domgarr/ScoreboardManager/(threads)

Thread 1 (2018-05-18):

At possible point, after "Spin to Win" is rendered, the losing team side does not update.

domgarr, 2018-05-18:
As of now, when pressing plus/minus button only one side of the scoreboard is updated. This leaves the score at "24 : Win" . Since the right side, which is losing, does not update because we gave the left side a point thus only rendering the left side.

domgarr, 2018-05-21:
Fixed by changing renderScore method to always render, before for rendering to occur the prev/curr state of the scores had to be different.

Closed 2018-05-21.

Thread 3 (2018-05-18):

Correct input values of NO switch such that plus/minus are adjacent.

domgarr, 2018-05-18:
This is pertaining to input values the NO switch are connected to on the board.
While testing the board, I tested out different input values on the board. IE, I switch the red plus NO switch to 3 and red minus NO switch to 11. This seems random, but it did so because the switches weren't activating prior to switching. What i think the problem is , is that since i haven't soldered the connection yet, it is very weak.
This should be done for readability and plainly due to the fact that it makes sense.

domgarr, 2018-05-21:
Fixed blue pin references are now adjacent (3,5) and red pins are (12,13). The gap between the numbers allowed for less congestion between the wires.

Closed 2018-05-21.

Thread 4 (2018-05-21):

Buttons pressed and rendering

domgarr, 2018-05-21:
I recently changed the buttons to render conditionally, but that isn't needed for the buttons, because we aren't checking another source - the watch - to see if there was a change. We know if the buttons are pressed, the states are not the same, render!

domgarr, 2018-05-22:
Fixed. I was correct in the button presses not needing conditional rendering.

Closed 2018-05-22.
