domgarr/ScoreboardManager/(commit log)

2018-01-29 Fixed a bug where 'Spin to Win would flash after the game was won
    [scoreboard_manager.ino]
2018-05-16 feat: Added flag for button mode and added controllers for blue side plus/minus refactor: Extracted rendering to methods
2018-05-18 feat: added red buttons for plus/minus, added reset button refactor: deleted unused code
2018-05-21 refactor: Changed button pins references so same colored buttons are adjacent
2018-05-21 Commited to wrong branch This reverts commit 514929eb7f4bf1a00c985ba7b6079fa3b70bb484.
    [scoreboard_manager.ino]
2018-05-21 refactor: Change button pins references, such that same colored buttons are adjacent
2018-05-21 bug: Readd deleted mappings for displaying "Spin to Win"
    [scoreboard_manager.ino]
2018-05-21 bugfix: Opposing team score now updates after "Spin to Win" is flashed. refactor: renderScore refactored to allow for rendering score even if prev/curr scores are the same and extracted rendering con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
    [scoreboard_manager.ino]
2018-05-22 refactor: remove conditional rendering on button presses
2018-06-18 feat: decrease brightness of LEDs refactor: remove unecessary check in watch mode
2019-09-16 Move scoreboard_manager.ino into a folder, as required by Arduino ide
2019-09-16 Move BluefruitConfig to correct folder
    [scoreboard_manager.ino]
