domgarr/ScoreboardManager/images/backside.jpg

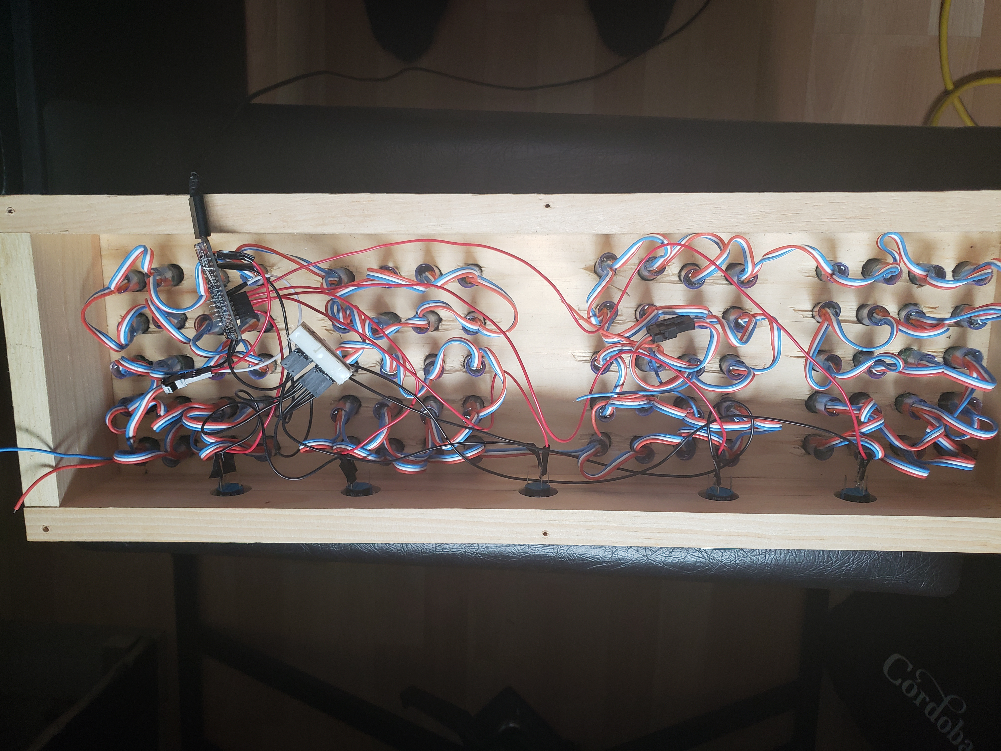
[picture p5: images/backside.jpg]
images/backside.jpg
