domgarr/ScoreboardManager/images/micro_back.jpg

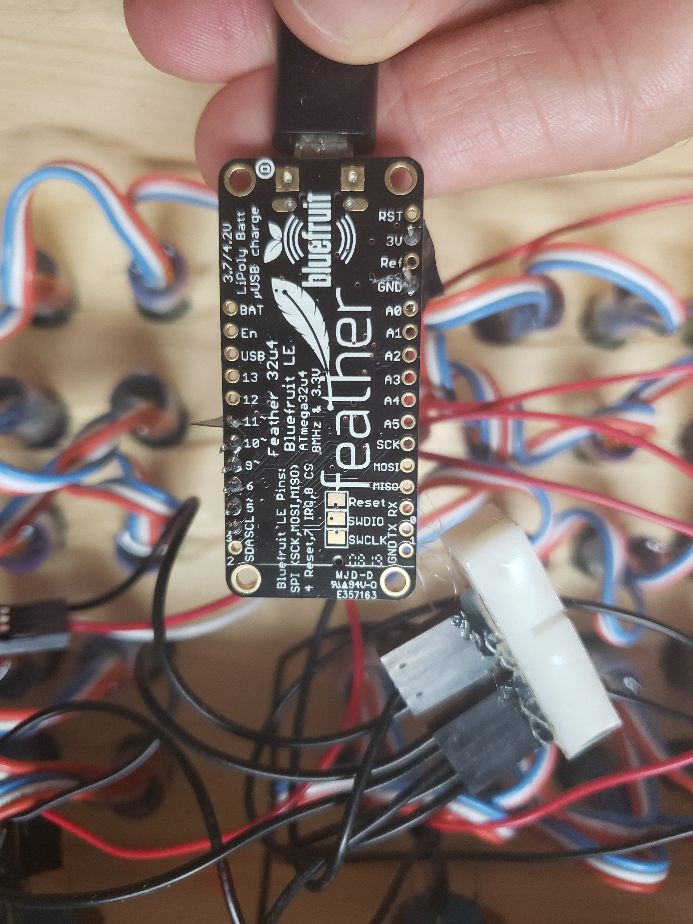
[picture p9: images/micro_back.jpg]
images/micro_back.jpg
