domgarr/ScoreboardManager/images/breadboard.jpg

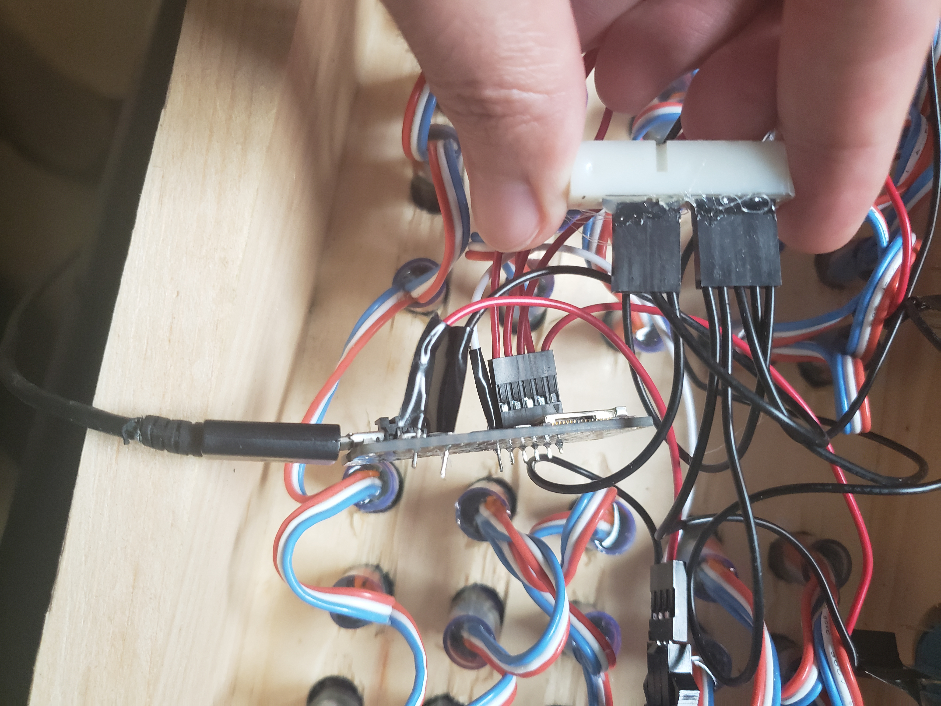
[picture p10: images/breadboard.jpg]
images/breadboard.jpg
