domgarr/ScoreboardManager/images/pushbutton.jpg

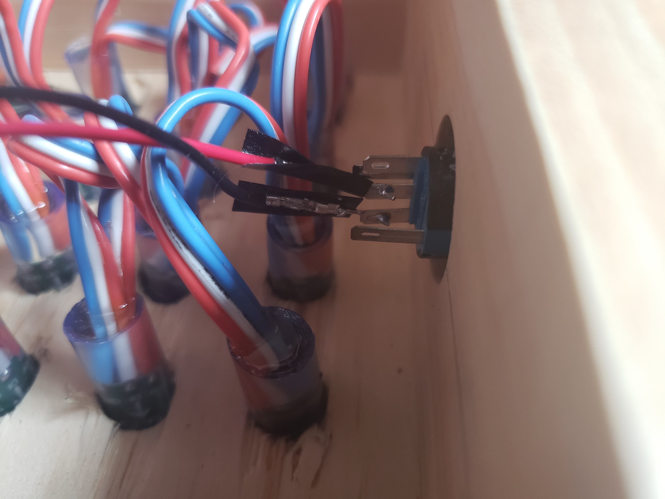
[picture p11: images/pushbutton.jpg]
images/pushbutton.jpg
